Shine16/HackAJeep/HackAJeep v3 schematic/HackAJeep3.sch

## EAGLE design HackAJeep v3 schematic/HackAJeep3.sch (2016-10-04)

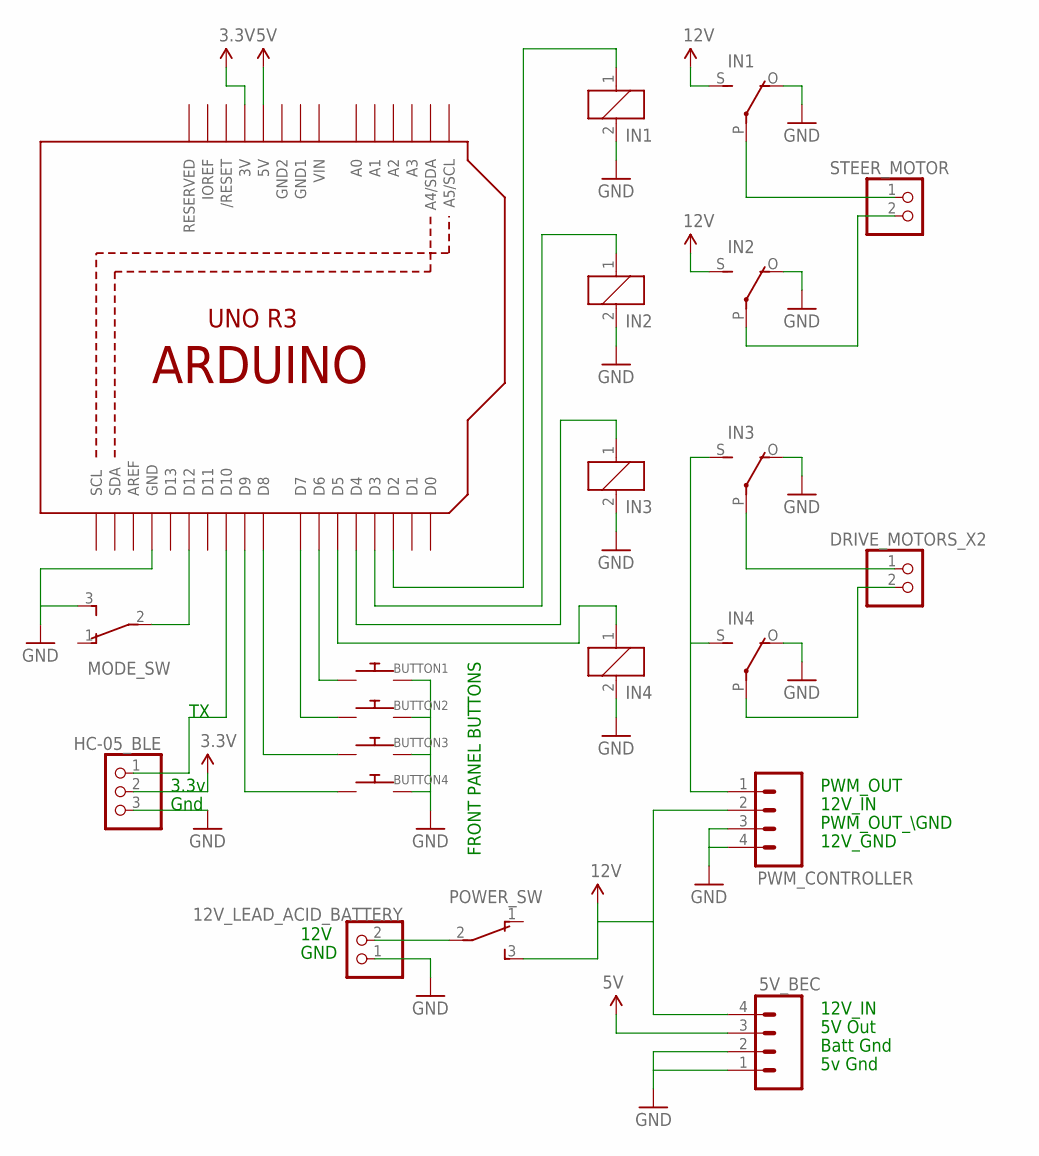
[picture p10: schematic HackAJeep3.sch]

Parts:
5V_BEC: M04POLAR; MOLEX-1X4
12V_LEAD_ACID_BATTERY: PINHD-1X2; 1X02
BUTTON1, BUTTON2, BUTTON3, BUTTON4: SWITCH_PUSHBUTTONSOFTTOUCHSMD_SJ; PUSHBUTTON_SMD_SJ
DRIVE_MOTORS_X2: PINHD-1X2; 1X02
HC-05_BLE: PINHD-1X3; 1X03
IN1, IN2, IN3, IN4: E3206L
MODE_SW: TL36WO; TL3XWO
POWER_SW: TL36WO; TL3XWO
PWM_CONTROLLER: M04POLAR; MOLEX-1X4
STEER_MOTOR: PINHD-1X2; 1X02
U1: ARDUINOR3-DIMENSION; ARDUINOR3

Connections:
3.3V: HC-05_BLE.2, U1.3V
5V: 5V_BEC.3, U1.5V
12V: 5V_BEC.4, IN1.S, IN2.S, POWER_SW.3 (S), PWM_CONTROLLER.2
GND: 5V_BEC.1, 5V_BEC.2, 12V_LEAD_ACID_BATTERY.1, BUTTON1.P$2, BUTTON2.P$2, BUTTON3.P$2, BUTTON4.P$2, HC-05_BLE.3, IN1.2, IN1.O, IN2.2, IN2.O, IN3.2, IN3.O, IN4.2, IN4.O, MODE_SW.3 (S), PWM_CONTROLLER.3, PWM_CONTROLLER.4, U1.GND
unnamed: IN2.P, STEER_MOTOR.2
unnamed: DRIVE_MOTORS_X2.1, IN3.P
unnamed: DRIVE_MOTORS_X2.2, IN4.P
unnamed: IN3.S, IN4.S, PWM_CONTROLLER.1
unnamed: IN1.1, U1.D2
unnamed: IN2.1, U1.D3
unnamed: IN3.1, U1.D4
unnamed: IN4.1, U1.D5
unnamed: BUTTON1.P$1, U1.D6
unnamed: BUTTON2.P$1, U1.D7
unnamed: BUTTON3.P$1, U1.D8
unnamed: BUTTON4.P$1, U1.D9
unnamed: HC-05_BLE.1, U1.D10
unnamed: MODE_SW.2, U1.D12
unnamed: 12V_LEAD_ACID_BATTERY.2, POWER_SW.2
STEER_MOTOR: IN1.P, STEER_MOTOR.1

Notes on the sheet:
3.3v
Gnd
Batt Gnd
5v Gnd
5V Out
12V_IN
PWM_OUT
PWM_OUT_\GND
12V_GND
FRONT PANEL BUTTONS
12V
GND
